s-ltf/IMS/source/Robot_and_Vehicle/POI/door_image.jpeg

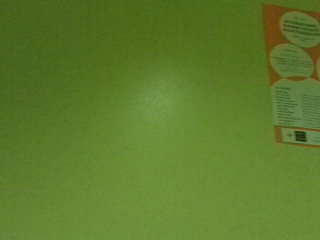
source/Robot_and_Vehicle/POI/door_image.jpeg
