s-ltf/IMS/source/Robot_and_Vehicle/POI/image.jpeg

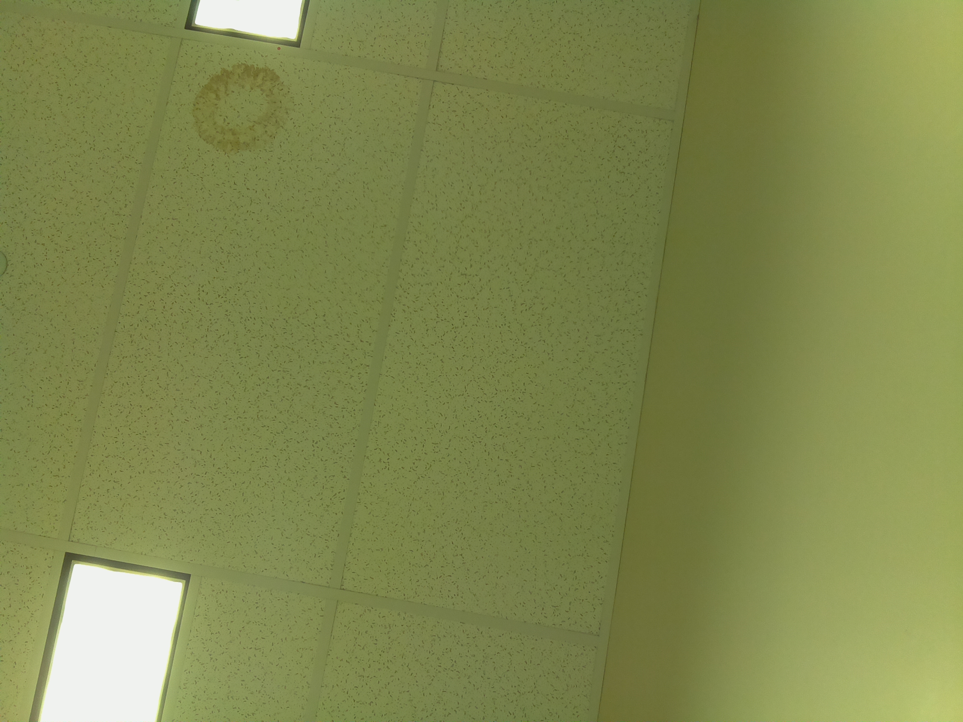
source/Robot_and_Vehicle/POI/image.jpeg
