s-ltf/IMS/source/Robot_and_Vehicle/SensorInterfaceModule/SensorInterfaceModule.ino

// for both classes must be in the include path of your project
#include "I2Cdev.h"
#include "AK8975.h"
#include "MPU6050_6Axis_MotionApps20.h"
//#include "MPU6050_9Axis_MotionApps41.h"
//#include "MPU6050.h" // not necessary if using MotionApps include file

// Arduino Wire library is required if I2Cdev I2CDEV_ARDUINO_WIRE implementation
// is used in I2Cdev.h
#if I2CDEV_IMPLEMENTATION == I2CDEV_ARDUINO_WIRE
    #include "Wire.h"
#endif

MPU6050 mpu; 
//MPU6050 mpu(0x69); // <-- use for AD0 high

// uncomment "OUTPUT_READABLE_YAWPITCHROLL" if you want to see the yaw/
// pitch/roll angles (in degrees) calculated from the quaternions coming
// from the FIFO. Note this also requires gravity vector calculations.
// Also note that yaw/pitch/roll angles suffer from gimbal lock (for
// more info, see: http://en.wikipedia.org/wiki/Gimbal_lock)
#define OUTPUT_READABLE_YAWPITCHROLL

// uncommednt "OUTPUT_MAG" to get Raw Mag data
// doesn't work for as far as I can tell :s
//#define OUTPUT_MAG

// uncommednt "OUTPUT_SONAR" to get Sonar distance data
#define OUTPUT_SONAR

// uncommednt "OUTPUT_ENCODERS" to get Sonar distance data
#define OUTPUT_ENCODERS

#define OUTPUT_ENCODER_YAW
int useEncoderYaw = 0;

//uncomment if the carrier is connected and you want to control it
#define CARRIER_ENABLED
//#define CALIBRATE_MOTOR_SPEED

//define OUTPUT_SERIAL to output data on the serial bus as expected by the Communication module
#define OUTPUT_SERIAL

//set to 1 to get extra print statements! be ware of a flodded serial port :)
int VERBOSE;
int stdVERBOSE = 1;

// MPU control/status vars
bool dmpReady = false;  // set true if DMP init was successful
uint8_t mpuIntStatus;   // holds actual interrupt status byte from MPU
uint8_t devStatus;      // return status after each device operation (0 = success, !0 = error)
uint16_t packetSize;    // expected DMP packet size (default is 42 bytes)
uint16_t fifoCount;     // count of all bytes currently in FIFO
uint8_t fifoBuffer[64]; // FIFO storage buffer
float GyroCalibOffset = 0.0;
float GyroParllWallOffset = 0.0;
volatile bool mpuInterrupt = false;     // indicates whether MPU interrupt pin has gone high

// orientation/motion vars
Quaternion q;           // [w, x, y, z]         quaternion container
VectorInt16 aa;         // [x, y, z]            accel sensor measurements
VectorInt16 aaReal;     // [x, y, z]            gravity-free accel sensor measurements
VectorInt16 aaWorld;    // [x, y, z]            world-frame accel sensor measurements
VectorFloat gravity;    // [x, y, z]            gravity vector
float euler[3];         // [psi, theta, phi]    Euler angle container
float ypr[3];           // [yaw, pitch, roll]   yaw/pitch/roll container and gravity vector
int yprIter = 0;
float yprAgg[3] = {0.0,0.0,0.0};
int yprIterMax  = 1;
bool GyroCalibrated = false;
int tempYaw = 0;
float calibYaw = 0;
float targetYaw = 0.0;
float encYaw = 0.0;

int insaneCounter = 0;
int insaneFlag = 0;

unsigned long mpuTimer = 0;

// packet structure for InvenSense teapot demo
uint8_t teapotPacket[14] = { '$', 0x02, 0,0, 0,0, 0,0, 0,0, 0x00, 0x00, '\r', '\n' };

//Mag globals
AK8975 mag(0x0C);
int16_t mx, my, mz;

//Encoder globals
int LastEncoderPinValue[2] = {0,0};
float WheelDistance[2] = {0.0, 0.0};
unsigned long WheelSpeedTimer[2] = {0,0};
unsigned long LastTickTime[2] = {0,0};
float WheelSpeed[2] = {0.0, 0.0};
float EncoderTickDistance = 188.5/800.0;

long int EncoderCount[2] = {0,0};
long int YawEncoderCount[2] = {0,0};
long int LastEncoderCount[2] = {0,0};
long int DriveEncoderCount[2] = {0,0};
unsigned long EncoderYawTimer = 0;

//Sonar globals
int SonarUpdated = 0;
const int SonarCount = 3;
long SonarPulse[SonarCount] = {0,0,0};
float SonarDist[SonarCount] = {0.0,0.0,0.0};
float WallDist[SonarCount] = {0.0,0.0,0.0};
bool SonarTrigFlag[SonarCount] = {false,false,false};
unsigned long SonarPollingCompare = 0;
unsigned long SonarTimer[SonarCount] = {0,0,0};
int SonarDistCount[SonarCount] = {0,0,0};
int SonarDistCountMax = 20;
bool SonarFilter[SonarCount] ={false,false,false};

int SonarPwmPin[SonarCount] = {2,3,14}; //array of pins that sonnars are connected to *** left - right - front
int SonarIntrptPin[SonarCount] = {0,1};
int SonarTrigPin[SonarCount] = {50,50,24};
bool SonarUpdatedFlag[SonarCount] = {false, false, false};
int SonarToPing = 0;

unsigned long SonarTickTimer[SonarCount] = {0,0,0};

//Hardware pins
int EncoderPin[2] = {19,18};    // *** LEFT - RIGHT
int EncoderIntrptPin[2] = {4,5};
int MotorPwmPin[2] = {5,11};
int MotorDirPin[2] = {12,13};
int MotorBrkPin[2] = {9,8};
int CurrentSensePin[2] = {A0,A1};
int MPUIntPin = 15;
int MotorDir[2] = {0,0};

//Misc Globals
float InchesToCm = 2.54;
int LEFT = 0;
int RIGHT = 1;
int FRONT = 2;
unsigned long EncoderPollingTimer = 0;
unsigned long AngleCheckTimer = 0;
float reqSpeed = 0;
float reqAngle = 0;
bool robotPrallelToWall = false;
bool newDataFlag = false;
bool newGyroDataFlag = false;
bool firstRunFlag = false;

// ================================================================
// ===                      MAIN SETUP                          ===
// ================================================================

void setup()
{
  Serial.begin(9600);
  #ifdef OUTPUT_READABLE_YAWPITCHROLL
    SetupMPU();
    CalibrateGyro();
  #endif
  
  #ifdef OUTPUT_MAG
    SetupMag();
  #endif
  
  #ifdef OUTPUT_SONAR
    SetupSonar();
  #endif
  
  #ifdef OUTPUT_ENCODERS
    SetupEncoders();
  #endif
  
  #ifdef CARRIER_ENABLED
    SetupMotors();
  #endif
}


// ================================================================
// ===                    MAIN PROGRAM LOOP                     ===
// ================================================================

void loop()
{
    VERBOSE = 0; //global flag for serial printing
    
//********************************************************************************************************* 0 ms
    /*#ifdef OUTPUT_SONAR
    // trigger the sonars
    if(isAngleRequested)
    {
      if((millis() - SonarTickTimer[SonarToPing]) > 120)
      {
        digitalWrite(SonarTrigPin[SonarToPing], HIGH);
        SonarReadFlag[SonarToPing] = 1;
        SonarTickTimer[SonarToPing] = millis();
        //delay(1);
        //digitalWrite(SonarTrigPin[SonarToPing], LOW);
      }
    }
    #endif*/
    
    #ifdef OUTPUT_SERIAL
    //VERBOSE = 1;
    receiveData();
    //VERBOSE = 0;
    #endif
    
    checkMPU();
    
    #ifdef OUTPUT_ENCODERS
    VERBOSE? Serial.println("Get Encoders") : 0;
    if(millis() - EncoderPollingTimer > 10)
    {
      GetEncoderData(RIGHT);
      GetEncoderData(LEFT);
      EncoderPollingTimer = millis();
    }
    #endif
    
    checkMPU();
    
    #ifdef CARRIER_ENABLED
    VERBOSE? Serial.println("Set Carrier"): 0;
    //VERBOSE = 1;
    DriveCarrier();
    //VERBOSE = 0;   
    #endif
    
    checkMPU();
    
    #ifdef OUTPUT_SONAR
    /*if( ((millis() - SonarTickTimer[SonarToPing]) > 15) && SonarReadFlag[SonarToPing] && isAngleRequested)
    {
      
      VERBOSE? Serial.println("Get Sonar") : 0;
      GetSonarDist();
      //reset flags
      SonarReadFlag[SonarToPing] = 0;
      digitalWrite(SonarTrigPin[SonarToPing], LOW);
      SonarTickTimer[SonarToPing] = millis();
      
    }*/
    VERBOSE? Serial.println("Get Sonar") : 0;
    //polling front sonar
    if (millis() >= SonarTimer[FRONT])
      PollSonarDist(FRONT);
     
    GetSonarDist();
    #endif
    
    checkMPU();
    
    #ifdef OUTPUT_MAG
    VERBOSE? Serial.println("Get Mag") : 0;
    GetMagHeading();
    #endif
    
    checkMPU();
    
}

void checkMPU()
{
    #ifdef OUTPUT_READABLE_YAWPITCHROLL
    VERBOSE? Serial.println("Get YPR") : 0;
    if(mpuInterrupt || (mpuTimer<millis()) )
    {
      (mpuTimer<millis())?(Serial.println("MPU INT STOPPED")):0;
      mpuTimer = millis() + 1000;
      //mpuInterrupt = false;
      //Serial.println("IntOFF");
      GetGyroData();
      //Serial.println("IntON");
    }
    #endif
}
