s-ltf/IMS/source/Robot_and_Vehicle/POI/Client.h

#ifndef CLIENT_H
#define CLIENT_H

#include <stdlib.h>
#include <stdlib.h>
#include <iostream>
#include <string.h>

using namespace std;

class Client
{
	public:
		Client(const char*, int);
		void Send(const char*);
		string Receive();
};
#endif
