s-ltf/IMS/source/Robot_and_Vehicle/POI/OCR.h

#ifndef OCR_H
#define OCR_H

#include <iostream>
#include <string.h>

using namespace std;
class OCR
{
	private:
		string image;
		string output;
	public:
		OCR(string);
		void Run(string);
		string Result();
};

#endif
