s-ltf/IMS/(commit log)

2014-02-03 adding first draft of dbWrapper, plus a new edition of the webserver,and some test code for threading
2014-03-10 Documentation and New SIM code
    added the latest Sensor Interface Module and Carrier Module.
    Updates support the new hardware (Polulu motors) and changed all the
    sensors to interrupts
2014-03-13 Adding testing scripts for socket server and client
2014-05-08 Adding a C socket library,for potential usage
2014-05-08 extracted raw x,y,and yaw from the serial feed on the vehicle,attempting to simulate serial feed. data will be used for running tests and creating a record,replay functionality on the website
2014-05-20 adding foundation framework files
2014-05-20 some tesitng code for using sockets io to communicate between website and server
